Dooez/thoren-build/step/keycaps/readme.md

Thumb cluster keycaps are numbered starting from the outermost key.
`thumb-1` and `thumb-2` have small dots on the bottom near the neighboring edges to distinguish `thumb-1` form `thumb-3`.
