Dooez/thoren-build/content/15-two-hales-top.jpg

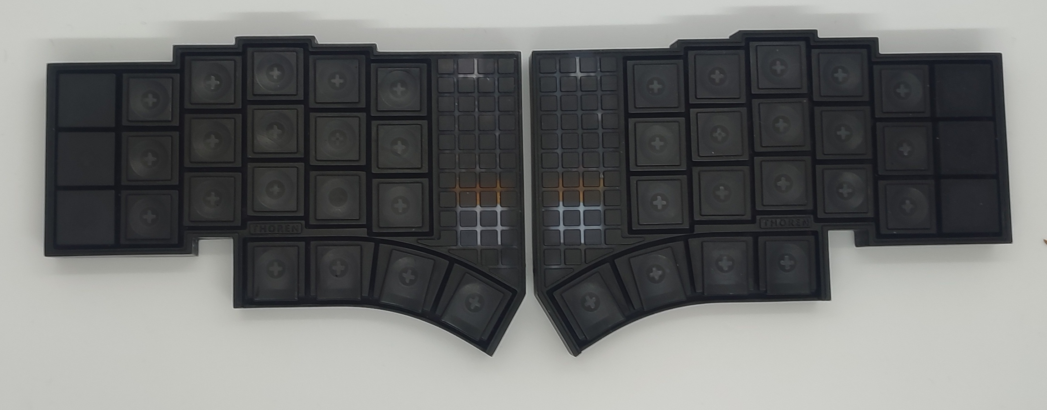
content/15-two-hales-top.jpg
