Dooez/thoren-build/step/carrying-case/carrying-case-inner.STEP

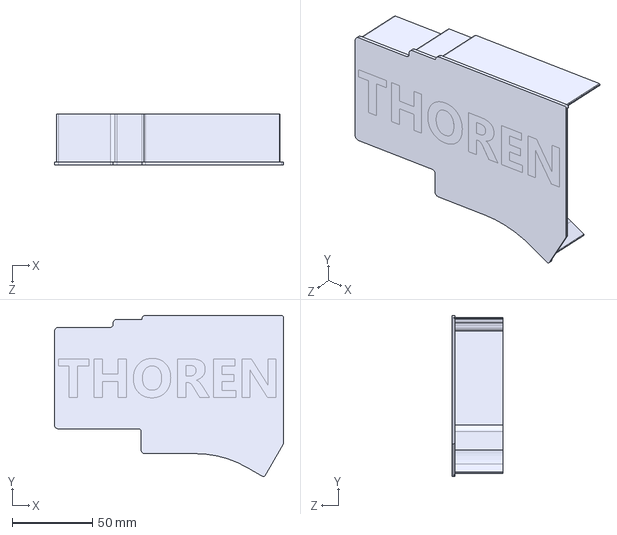
[picture p27: CAD file, 2025-01-28]
step/carrying-case/carrying-case-inner.STEP
142.9 x 100.6 x 32.0 mm
