Dooez/thoren-build/step/keycaps/keycap.STEP

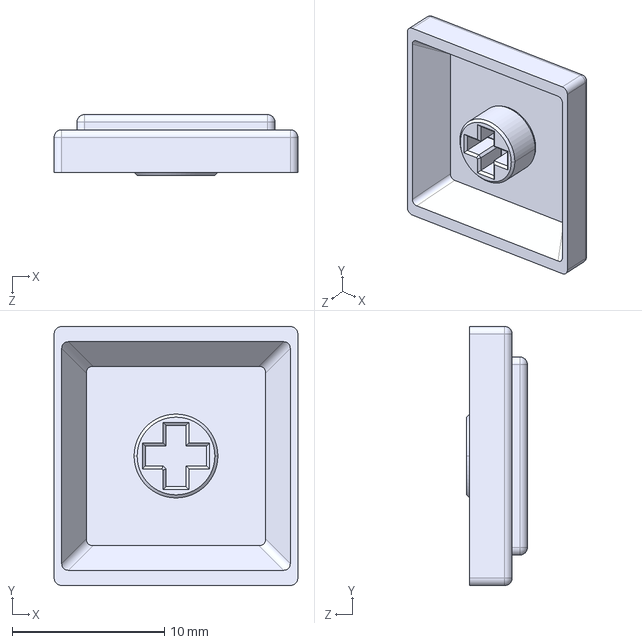
[picture p28: CAD file, 2025-01-28]
step/keycaps/keycap.STEP
16.0 x 17.0 x 4.00 mm
