Dooez/thoren-build/step/silicone-pouring/imitator-bottom.step

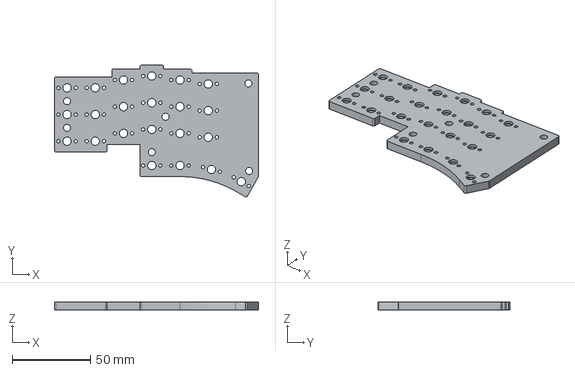
[picture p29: CAD file, 2025-01-28]
step/silicone-pouring/imitator-bottom.step
130.0 x 84.0 x 5.00 mm
