Dooez/thoren-build/step/switch.STEP

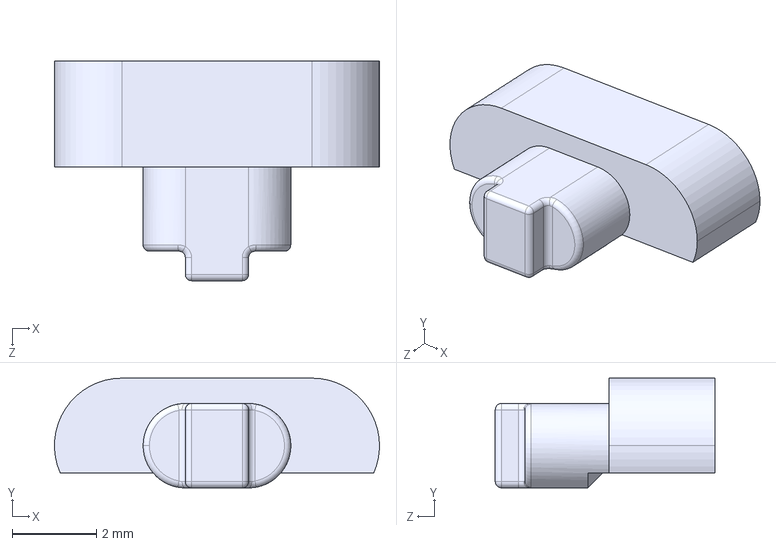
[picture p30: CAD file, 2025-01-28]
step/switch.STEP
7.70 x 2.60 x 5.20 mm
