Dooez/thoren-build/step/carrying-case/carrying-case-felt-cutout-template.STEP

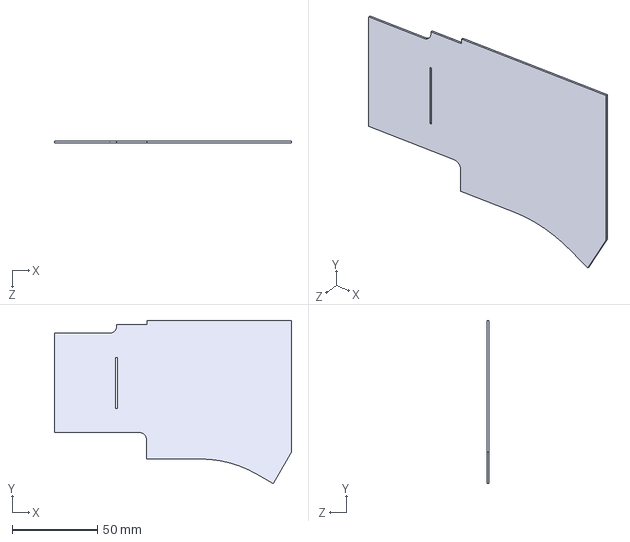
[picture p31: CAD file, 2025-01-28]
step/carrying-case/carrying-case-felt-cutout-template.STEP
139.3 x 96.0 x 1.00 mm
