Dooez/thoren-build/step/plate-top-left.STEP

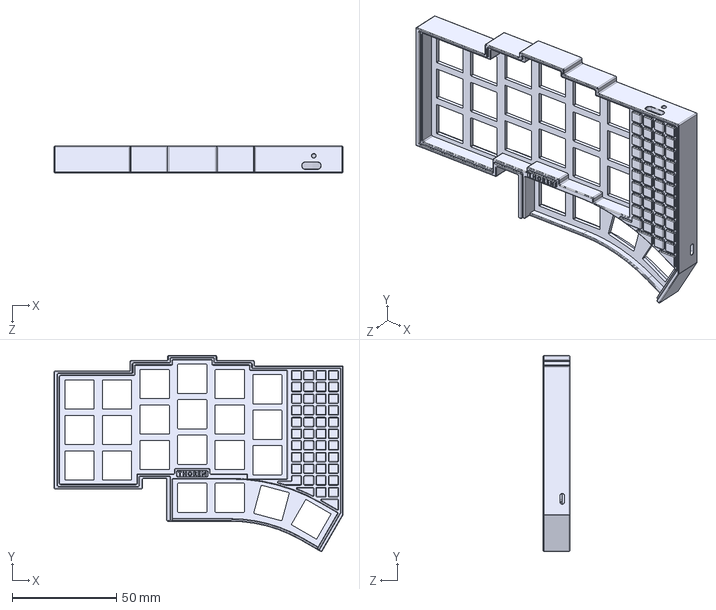
[picture p32: CAD file, 2025-01-28]
step/plate-top-left.STEP
138.5 x 94.0 x 12.7 mm
