Dooez/thoren-build/step/silicone-pouring/imitator-stem.step

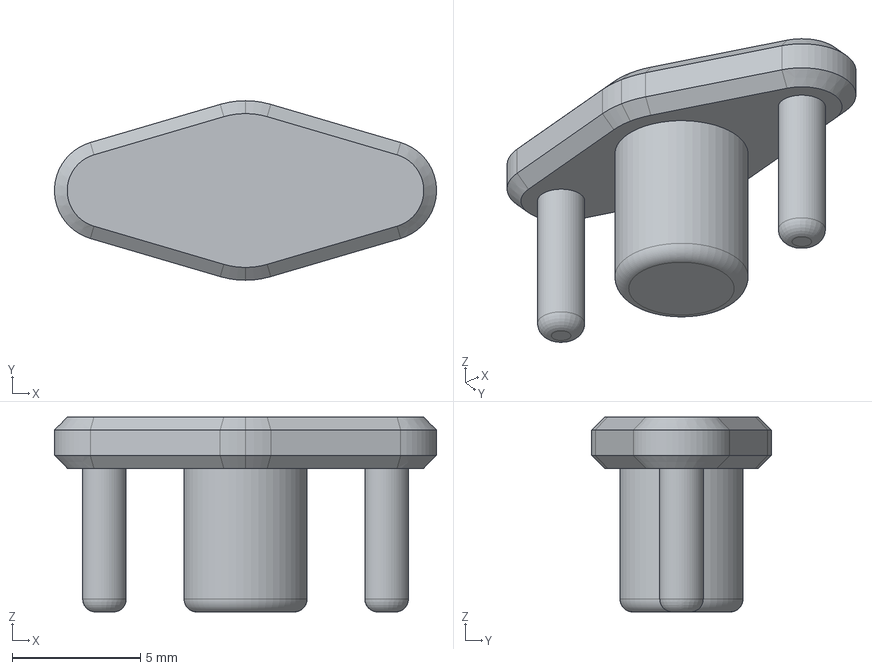
[picture p33: CAD file, 2025-01-28]
step/silicone-pouring/imitator-stem.step
14.9 x 7.00 x 7.60 mm
