Dooez/thoren-build/step/carrying-case/carrying-case-ribbon-holder.STEP

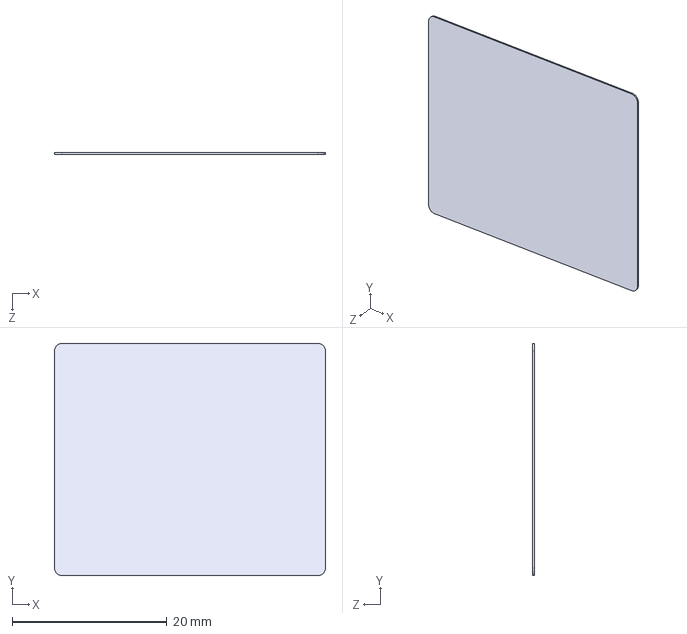
[picture p34: CAD file, 2025-01-28]
step/carrying-case/carrying-case-ribbon-holder.STEP
35.0 x 30.0 x 0.2 mm
