Dooez/thoren-build/step/keycaps/thumb-1.STEP

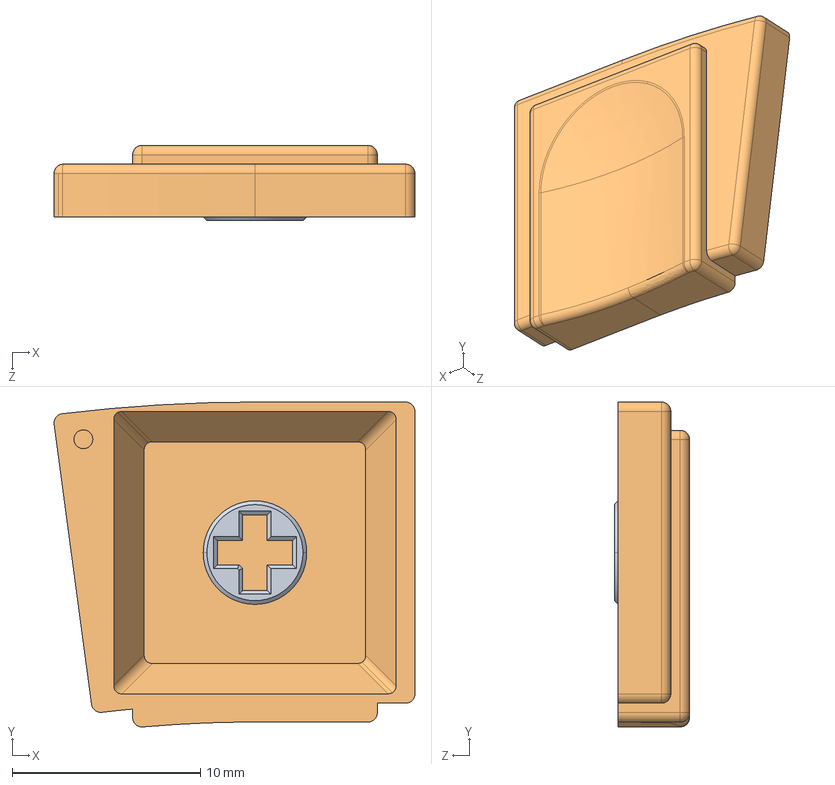
[picture p35: CAD file, 2025-01-28]
step/keycaps/thumb-1.STEP
19.2 x 17.3 x 4.00 mm
stem
thumb-1
