Dooez/thoren-build/step/silicone-pouring/silicone-cover.STEP

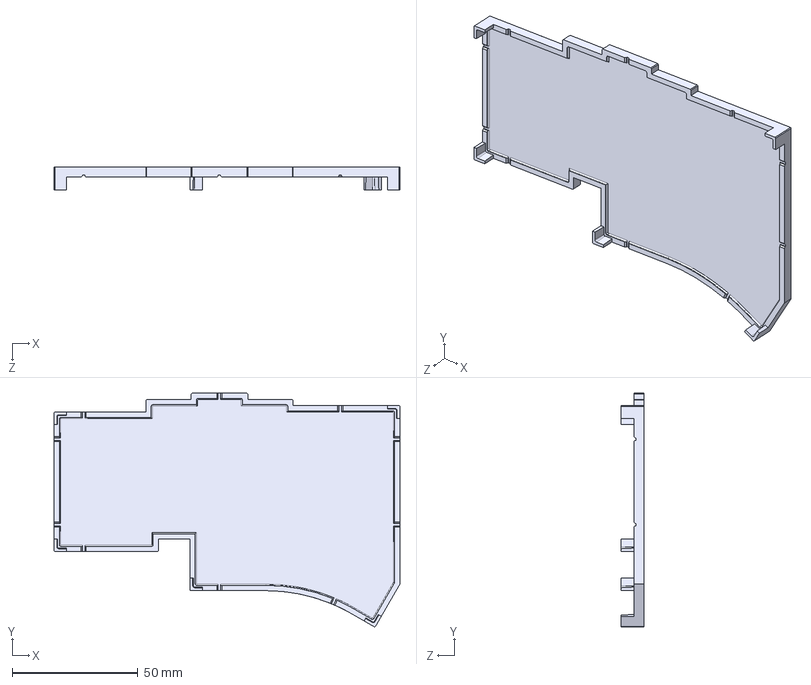
[picture p36: CAD file, 2025-01-28]
step/silicone-pouring/silicone-cover.STEP
137.5 x 92.9 x 9.00 mm
