Dooez/thoren-build/step/keycaps/thumb-4.STEP

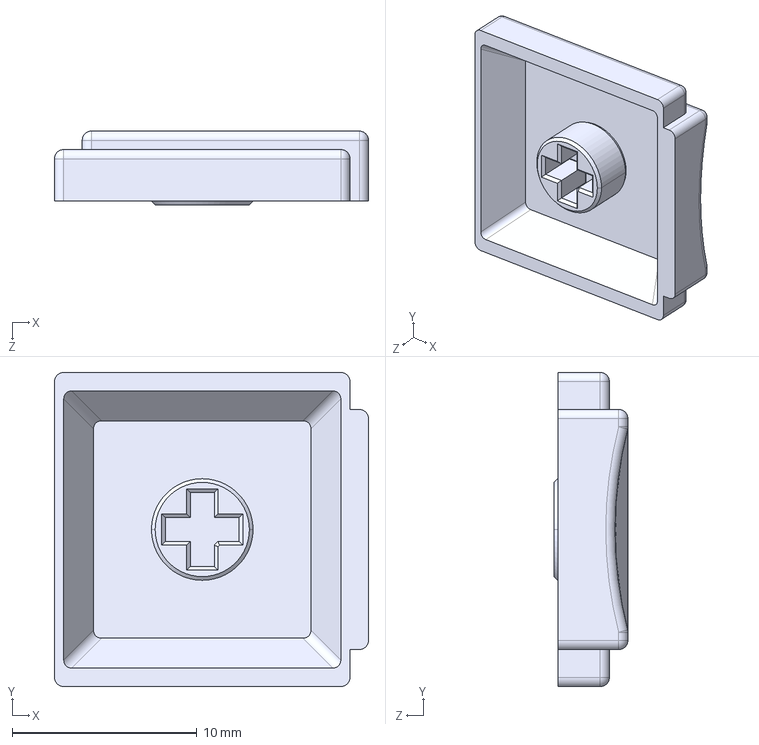
[picture p37: CAD file, 2025-01-28]
step/keycaps/thumb-4.STEP
17.0 x 17.0 x 4.00 mm
