Dooez/thoren-build/step/silicone-pouring/imitator-cover.step

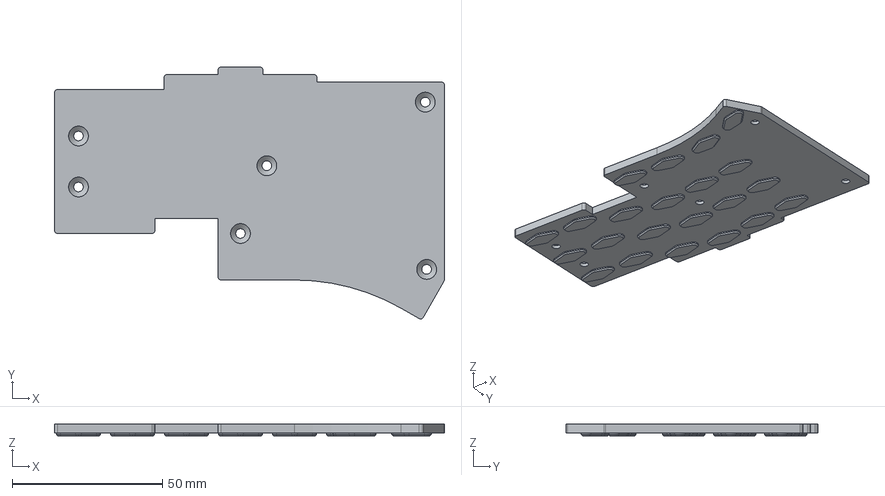
[picture p38: CAD file, 2025-01-28]
step/silicone-pouring/imitator-cover.step
130.0 x 84.0 x 4.00 mm
