Dooez/thoren-build/step/keycaps/thumb-2.STEP

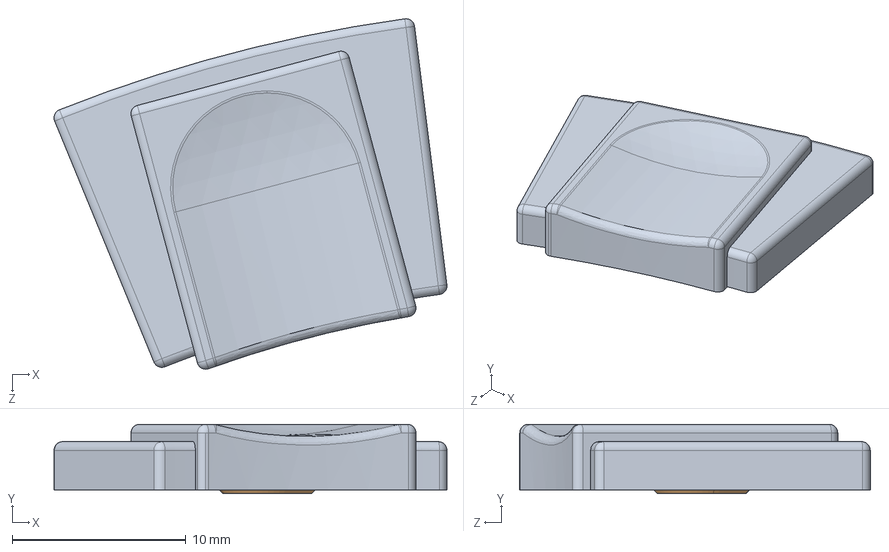
[picture p39: CAD file, 2025-01-28]
step/keycaps/thumb-2.STEP
22.6 x 4.00 x 20.2 mm
thumb-2
stem
