Dooez/thoren-build/step/silicone-pouring/silicone-walls.STEP

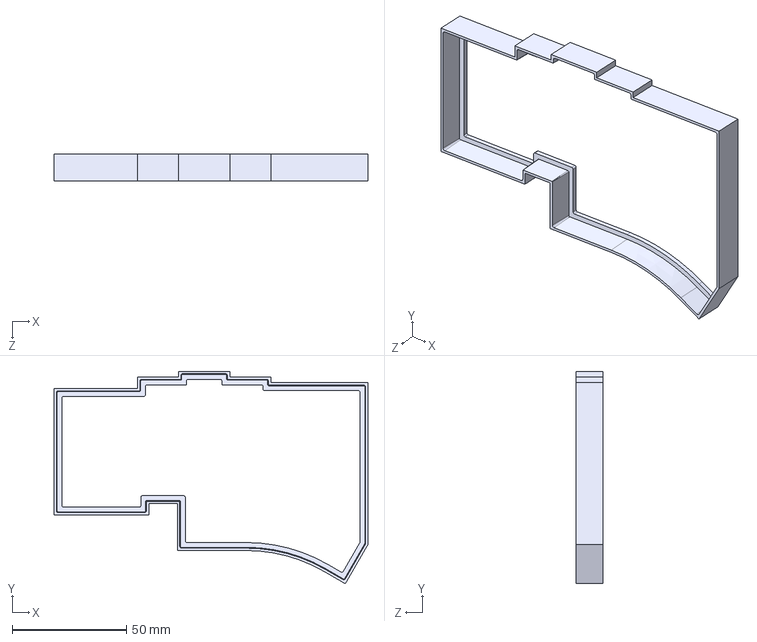
[picture p40: CAD file, 2025-01-28]
step/silicone-pouring/silicone-walls.STEP
137.5 x 93.0 x 12.0 mm
