Dooez/thoren-build/(list of files, cad)

Other CAD files:
step/keycaps/keycap-bump.STEP
step/plate-top-right.STEP
step/carrying-case/carrying-case-outer.STEP
step/keycaps/thumb-3.STEP
