Dooez/thoren-build/pcb/thoren.kicad_pcb

## KiCad design pcb/thoren.kicad_pcb (2025-01-28)

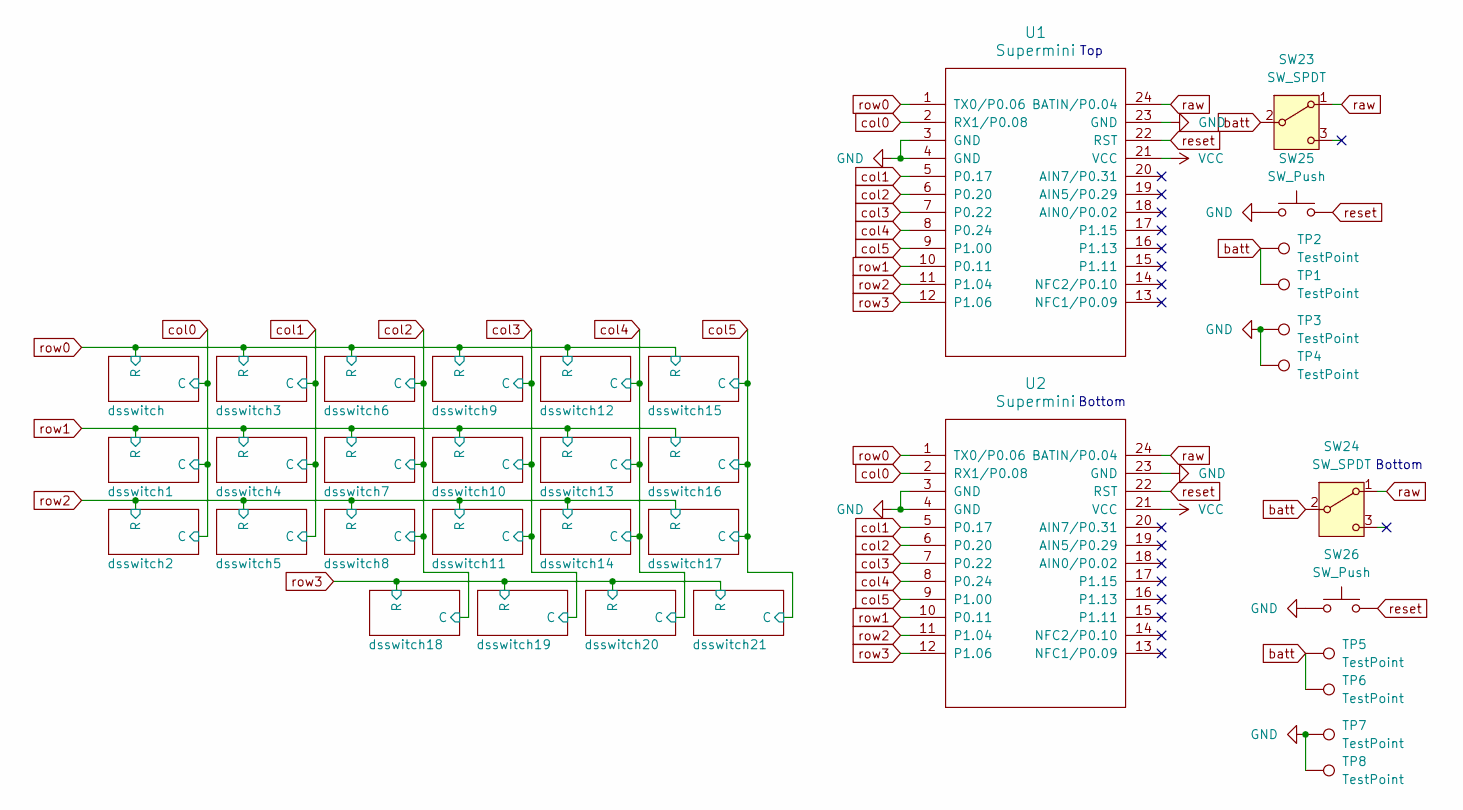
[picture p41: schematic thoren.kicad_sch]

Parts:
SW23, SW24: SW_SPDT; switch_SSSS811101
SW25, SW26: SW_Push; SW_Push_1P1T-MP_NO_Horizontal_Alps_SKRTLAE010
TP1, TP2, TP5, TP6: TestPoint; TestPoint_Pad_D2.0mm
TP3, TP4, TP7, TP8: TestPoint; TestPoint_Pad_2.0x2.0mm
U1, U2: Supermini; Supermini face up left smd socket

Connections:
GND: SW25.1, SW26.1, TP3.1, TP4.1, TP7.1, TP8.1, U1.3 (GND), U1.4 (GND), U1.23 (GND), U2.3 (GND), U2.4 (GND), U2.23 (GND)
VCC: U1.21 (VCC), U2.21 (VCC)
batt: SW23.2 (B), SW24.2 (B), TP1.1, TP2.1, TP5.1, TP6.1
col0: U1.2 (RX1/P0.08), U2.2 (RX1/P0.08); also elsewhere on the board
col1: U1.5 (P0.17), U2.5 (P0.17); also elsewhere on the board
col2: U1.6 (P0.20), U2.6 (P0.20); also elsewhere on the board
col3: U1.7 (P0.22), U2.7 (P0.22); also elsewhere on the board
col4: U1.8 (P0.24), U2.8 (P0.24); also elsewhere on the board
col5: U1.9 (P1.00), U2.9 (P1.00); also elsewhere on the board
raw: SW23.1 (A), SW24.1 (A), U1.24 (BATIN/P0.04), U2.24 (BATIN/P0.04)
reset: SW25.2, SW26.2, U1.22 (RST), U2.22 (RST)
row0: U1.1 (TX0/P0.06), U2.1 (TX0/P0.06); also elsewhere on the board
row1: U1.10 (P0.11), U2.10 (P0.11); also elsewhere on the board
row2: U1.11 (P1.04), U2.11 (P1.04); also elsewhere on the board
row3: U1.12 (P1.06), U2.12 (P1.06); also elsewhere on the board

Notes on the sheet:
Bottom
Top

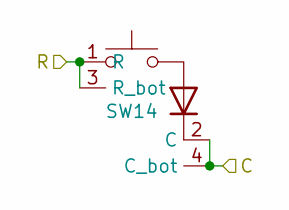
[picture p42: schematic dsswitch_sch.kicad_sch]

Parts:
SW14: choc_hotswap_18_17_sod123

Connections:
col4: SW14.2 (C), SW14.4 (C_bot); also elsewhere on the board
row1: SW14.1 (R), SW14.3 (R_bot); also elsewhere on the board

Parts of its further copies:
SW1, SW2, SW3, SW4, SW5, SW6, SW7, SW8, SW9, SW10, SW11, SW12, SW13, SW15, SW16, SW17, SW18, SW19, SW20, SW21, SW22: choc_hotswap_18_17_sod123

Connections of its further copies:
col0: SW1.2 (C), SW1.4 (C_bot), SW2.2 (C), SW2.4 (C_bot), SW3.2 (C), SW3.4 (C_bot); also elsewhere on the board
col1: SW4.2 (C), SW4.4 (C_bot), SW5.2 (C), SW5.4 (C_bot), SW6.2 (C), SW6.4 (C_bot); also elsewhere on the board
col2: SW7.2 (C), SW7.4 (C_bot), SW8.2 (C), SW8.4 (C_bot), SW9.2 (C), SW9.4 (C_bot), SW19.2 (C), SW19.4 (C_bot); also elsewhere on the board
col3: SW10.2 (C), SW10.4 (C_bot), SW11.2 (C), SW11.4 (C_bot), SW12.2 (C), SW12.4 (C_bot), SW20.2 (C), SW20.4 (C_bot); also elsewhere on the board
col4: SW13.2 (C), SW13.4 (C_bot), SW15.2 (C), SW15.4 (C_bot), SW21.2 (C), SW21.4 (C_bot); also elsewhere on the board
col5: SW16.2 (C), SW16.4 (C_bot), SW17.2 (C), SW17.4 (C_bot), SW18.2 (C), SW18.4 (C_bot), SW22.2 (C), SW22.4 (C_bot); also elsewhere on the board
row0: SW1.1 (R), SW1.3 (R_bot), SW4.1 (R), SW4.3 (R_bot), SW7.1 (R), SW7.3 (R_bot), SW10.1 (R), SW10.3 (R_bot), SW13.1 (R), SW13.3 (R_bot), SW16.1 (R), SW16.3 (R_bot); also elsewhere on the board
row1: SW2.1 (R), SW2.3 (R_bot), SW5.1 (R), SW5.3 (R_bot), SW8.1 (R), SW8.3 (R_bot), SW11.1 (R), SW11.3 (R_bot), SW17.1 (R), SW17.3 (R_bot); also elsewhere on the board
row2: SW3.1 (R), SW3.3 (R_bot), SW6.1 (R), SW6.3 (R_bot), SW9.1 (R), SW9.3 (R_bot), SW12.1 (R), SW12.3 (R_bot), SW15.1 (R), SW15.3 (R_bot), SW18.1 (R), SW18.3 (R_bot); also elsewhere on the board
row3: SW19.1 (R), SW19.3 (R_bot), SW20.1 (R), SW20.3 (R_bot), SW21.1 (R), SW21.3 (R_bot), SW22.1 (R), SW22.3 (R_bot); also elsewhere on the board

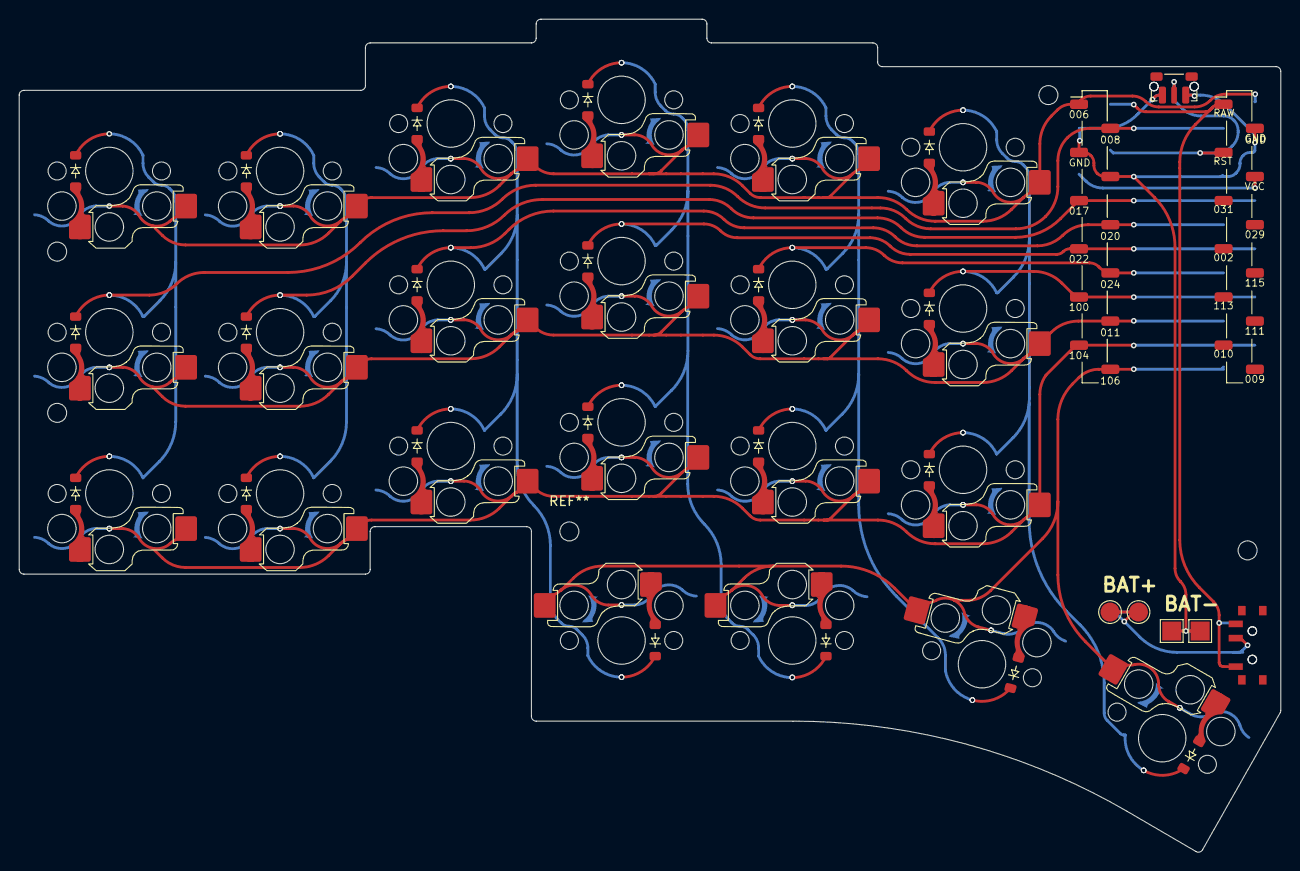
[picture p43: board thoren.kicad_pcb from above]

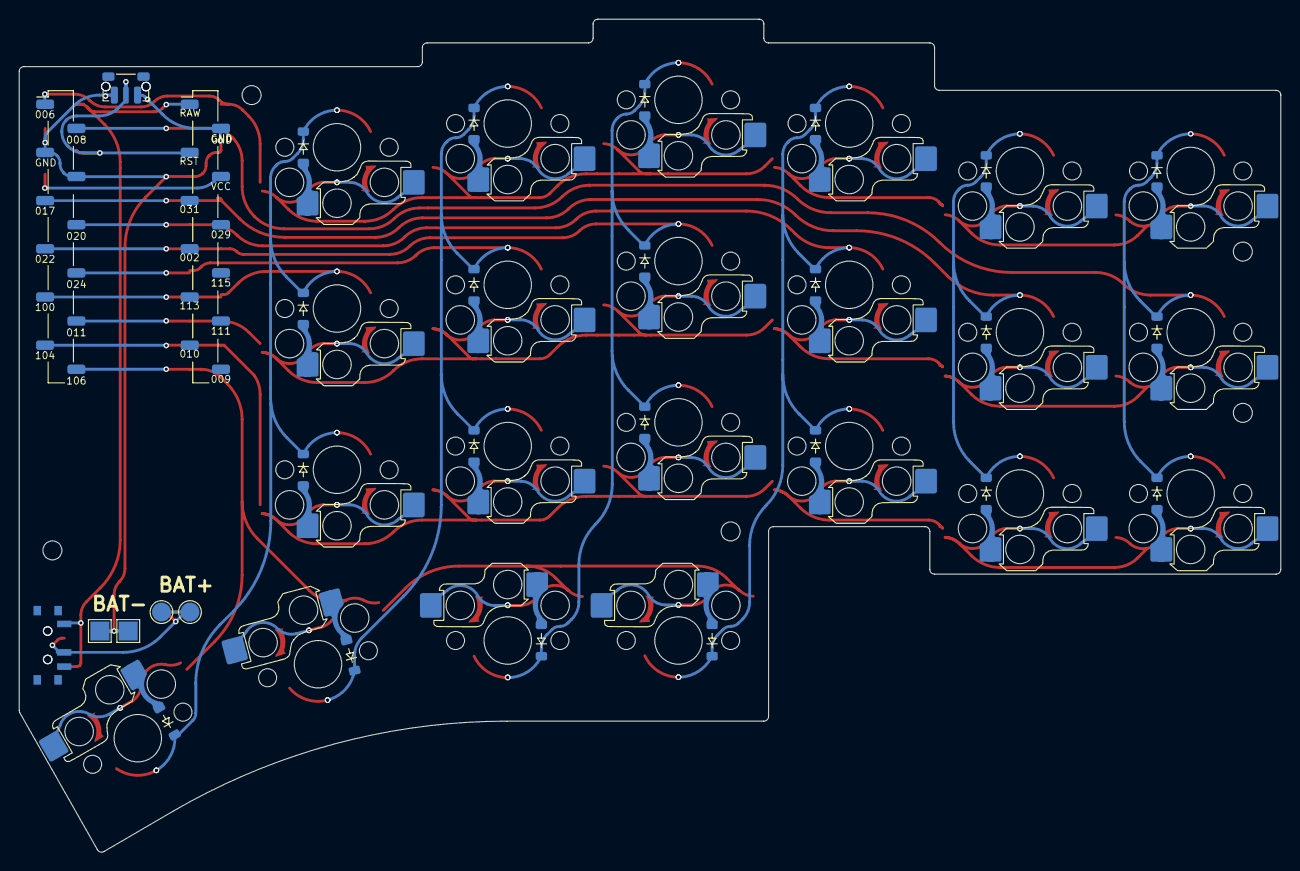
[picture p44: board thoren.kicad_pcb from below]

Board: 2 copper layers, 133.0 x 87.8 mm, 36 parts (11 on the bottom side), 15 nets.
