Dooez/thoren-build/(commit log)

2025-01-28 Added hardware.
    [carrying-case-felt-cutout-template.STEP, carrying-case-inner.STEP, carrying-case-outer.STEP, carrying-case-ribbon-holder.STEP, dsswitch_sch.kicad_sch, imitator-bottom.step, imitator-cover.step, imitator-stem.step]
2025-01-28 Added missing step and link.
    [switch.STEP]
